lowobservable/channel/README.md

# channel

IBM parallel channel adapter.

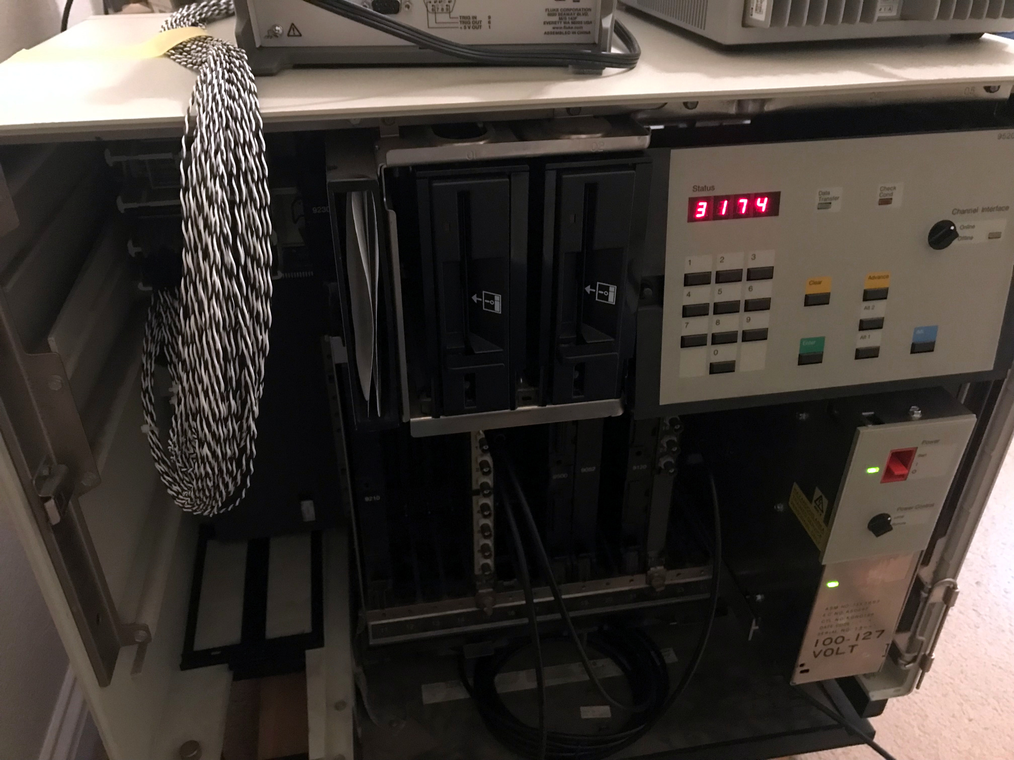
[picture p1: .images/photo1.jpg]
IBM 3174-1L


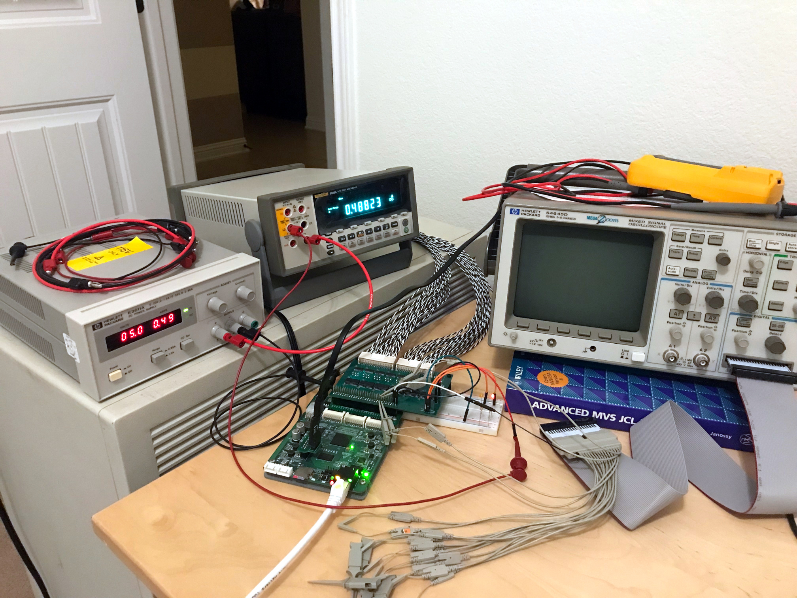
[picture p2: .images/photo2.jpg]
Adapter


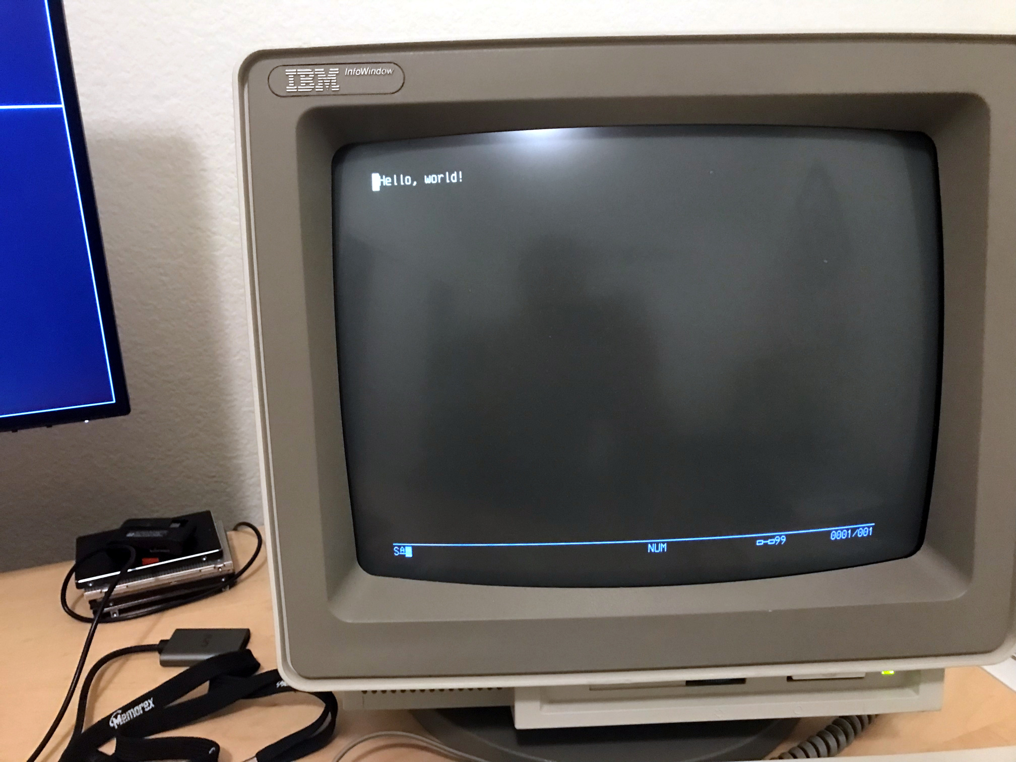
[picture p3: .images/photo3.jpg]
Hello World
