lowobservable/channel/adapter1/pcb/pinout.ods

Sheet: Pins
 | Signal | Zynq | J3 | J1 / J2 | Channel
Bus | Mark 0 In | H20 | 23 | J1 – 1 | Bus Out - J13
 | Mark 0 Out | M18 | 32 | J1 – 3 | Bus Out - D13
 | Bus In 7 | G19 | 24 | J1 – 5 | Bus Out - G12
 | Bus Out 7 | L19 | 29 | J1 – 7 | Bus Out - B12
 | Bus In 6 | D18 | 9 | J1 – 9 | Bus Out - J11
 | Bus Out 6 | J18 | 21 | J1 – 11 | Bus Out - D11
 | Bus In 5 | D20 | 10 | J1 – 13 | Bus Out - G10
 | Bus Out 5 | G20 | 22 | J1 – 15 | Bus Out - B10
 | Bus In 4 | C20 | 7 | J1 – 17 | Bus Out - J9
 | Bus Out 4 | K17 | 15 | J1 – 19 | Bus Out - D9
 | Bus In 3 | H17 | 8 | J1 – 21 | Bus Out - G8
 | Bus Out 3 | F19 | 16 | J1 – 23 | Bus Out - B8
 | Bus In 2 | B20 | 5 | J1 – 25 | Bus Out - J6
 | Bus Out 2 | E19 | 13 | J1 – 27 | Bus Out - D6
 | Bus In 1 | B19 | 6 | J1 – 29 | Bus Out - G5
 | Bus Out 1 | F20 | 14 | J1 – 31 | Bus Out - B5
 | Bus In 0 | H16 | 3 | J1 – 33 | Bus Out - J4
 | Bus Out 0 | D19 | 11 | J1 – 35 | Bus Out - D4
 | Bus In P | A20 | 4 | J1 – 37 | Bus Out - G3
 | Bus Out P | H18 | 12 | J1 – 39 | Bus Out - B3
Tag | Operational Out | T19 | 49 | J2 – 1 | Tag Out - J13
 | Service Out | U20 | 50 | J2 – 3 | Tag Out - D13
 | Hold Out | V20 | 52 | J2 – 5 | Tag Out - G12
 | Suppress Out | T20 | 47 | J2 – 7 | Tag Out - B12
 | Disconnect In | N17 | 43 | J2 – 9 | Tag Out - J11
 | Command Out | P19 | 48 | J2 – 11 | Tag Out - D11
 | Data Out | R19 | 45 | J2 – 13 | Tag Out - G10
 | Address Out | N20 | 39 | J2 – 15 | Tag Out - B10
 | Select Out | P18 | 42 | J2 – 19 | Tag Out - D9
 | Data In | R18 | 46 | J2 – 21 | Tag Out - G8
 | Select In | P20 | 44 | J2 – 23 | Tag Out - B8
 | Request In | M17 | 41 | J2 – 25 | Tag Out - J6
 | Service In | L16 | 30 | J2 – 27 | Tag Out - D6
 | Metering In | J20 | 27 | J2 – 29 | Tag Out - G5
 | Address In | K19 | 28 | J2 – 31 | Tag Out - B5
 | Metering Out | M19 | 40 | J2 – 33 | Tag Out - J4
 | Status In | J19 | 25 | J2 – 35 | Tag Out - D4
 | Clock Out | L20 | 31 | J2 – 37 | Tag Out - G3
 | Operational In | K18 | 26 | J2 – 39 | Tag Out - B3
Other | Driver Enable | U19 | 51
 | GPIO 0 | L17 | 33
 | GPIO 1 | M20 | 34

Sheet: Cable
JST | “A” | JST | “A”
1 | J13 | 2 | J12
3 | D13 | 4 | D12
5 | G12 | 6 | G13
7 | B12 | 8 | B13
9 | J11 | 10 | J10
11 | D11 | 12 | D10
13 | G10 | 14 | G9
15 | B10 | 16 | B9
17 | J9 | 18 | J8
19 | D9 | 20 | D8
21 | G8 | 22 | G7
23 | B8 | 24 | B7
25 | J6 | 26 | J7
27 | D6 | 28 | D7
29 | G5 | 30 | G4
31 | B5 | 32 | B4
33 | J4 | 34 | J5
35 | D4 | 36 | D5
37 | G3 | 38 | G2
39 | B3 | 40 | B2

Sheet: EBAZ4205 Breakout
 | GND | GND
Bus In 0 | H16 | A20 | Bus In P
Bus In 2 | B20 | B19 | Bus In 1
Bus In 4 | C20 | H17 | Bus In 3
Bus In 6 | D18 | D20 | Bus In 5
Bus Out 0 | D19 | H18 | Bus Out P
Bus Out 2 | E19 | F20 | Bus Out 1
Bus Out 4 | K17 | F19 | Bus Out 3
 | GND | GND
 | 3V3 | 3V3
Bus Out 6 | J18 | G20 | Bus Out 5
Mark 0 In | H20 | G19 | Bus In 7
Status In | J19 | K18 | Operational In
Metering In | J20 | K19 | Address In
Bus Out 7 | L19 | L16 | Service In
Clock Out | L20 | M18 | Mark 0 Out
GPIO 0 | L17 | M20 | GPIO 1
 | GND | GND
 | 3V3 | 3V3
Address Out | N20 | M19 | Metering Out
Request In | M17 | P18 | Select Out
Disconnect In | N17 | P20 | Select In
Data Out | R19 | R18 | Data In
Suppress Out | T20 | P19 | Command Out
Operational Out | T19 | U20 | Service Out
Driver Enable | U19 | V20 | Hold Out
 | GND | GND
 | 3V3 | 3V3

Sheet: XDC
Signal | Zynq | Port | XDC
Mark 0 In | H20 | A_MARK_0_IN_N | set_property -dict { PACKAGE_PIN H20 IOSTANDARD LVCMOS33 } [get_ports { A_MARK_0_IN_N }]; # Mark 0 In
Mark 0 Out | M18 | A_MARK_0_OUT | set_property -dict { PACKAGE_PIN M18 IOSTANDARD LVCMOS33 } [get_ports { A_MARK_0_OUT }]; # Mark 0 Out
Bus In 7 | G19 | A_BUS_IN_N[0] | set_property -dict { PACKAGE_PIN G19 IOSTANDARD LVCMOS33 } [get_ports { A_BUS_IN_N[0] }]; # Bus In 7
Bus Out 7 | L19 | A_BUS_OUT[0] | set_property -dict { PACKAGE_PIN L19 IOSTANDARD LVCMOS33 } [get_ports { A_BUS_OUT[0] }]; # Bus Out 7
Bus In 6 | D18 | A_BUS_IN_N[1] | set_property -dict { PACKAGE_PIN D18 IOSTANDARD LVCMOS33 } [get_ports { A_BUS_IN_N[1] }]; # Bus In 6
Bus Out 6 | J18 | A_BUS_OUT[1] | set_property -dict { PACKAGE_PIN J18 IOSTANDARD LVCMOS33 } [get_ports { A_BUS_OUT[1] }]; # Bus Out 6
Bus In 5 | D20 | A_BUS_IN_N[2] | set_property -dict { PACKAGE_PIN D20 IOSTANDARD LVCMOS33 } [get_ports { A_BUS_IN_N[2] }]; # Bus In 5
Bus Out 5 | G20 | A_BUS_OUT[2] | set_property -dict { PACKAGE_PIN G20 IOSTANDARD LVCMOS33 } [get_ports { A_BUS_OUT[2] }]; # Bus Out 5
Bus In 4 | C20 | A_BUS_IN_N[3] | set_property -dict { PACKAGE_PIN C20 IOSTANDARD LVCMOS33 } [get_ports { A_BUS_IN_N[3] }]; # Bus In 4
Bus Out 4 | K17 | A_BUS_OUT[3] | set_property -dict { PACKAGE_PIN K17 IOSTANDARD LVCMOS33 } [get_ports { A_BUS_OUT[3] }]; # Bus Out 4
Bus In 3 | H17 | A_BUS_IN_N[4] | set_property -dict { PACKAGE_PIN H17 IOSTANDARD LVCMOS33 } [get_ports { A_BUS_IN_N[4] }]; # Bus In 3
Bus Out 3 | F19 | A_BUS_OUT[4] | set_property -dict { PACKAGE_PIN F19 IOSTANDARD LVCMOS33 } [get_ports { A_BUS_OUT[4] }]; # Bus Out 3
Bus In 2 | B20 | A_BUS_IN_N[5] | set_property -dict { PACKAGE_PIN B20 IOSTANDARD LVCMOS33 } [get_ports { A_BUS_IN_N[5] }]; # Bus In 2
Bus Out 2 | E19 | A_BUS_OUT[5] | set_property -dict { PACKAGE_PIN E19 IOSTANDARD LVCMOS33 } [get_ports { A_BUS_OUT[5] }]; # Bus Out 2
Bus In 1 | B19 | A_BUS_IN_N[6] | set_property -dict { PACKAGE_PIN B19 IOSTANDARD LVCMOS33 } [get_ports { A_BUS_IN_N[6] }]; # Bus In 1
Bus Out 1 | F20 | A_BUS_OUT[6] | set_property -dict { PACKAGE_PIN F20 IOSTANDARD LVCMOS33 } [get_ports { A_BUS_OUT[6] }]; # Bus Out 1
Bus In 0 | H16 | A_BUS_IN_N[7] | set_property -dict { PACKAGE_PIN H16 IOSTANDARD LVCMOS33 } [get_ports { A_BUS_IN_N[7] }]; # Bus In 0
Bus Out 0 | D19 | A_BUS_OUT[7] | set_property -dict { PACKAGE_PIN D19 IOSTANDARD LVCMOS33 } [get_ports { A_BUS_OUT[7] }]; # Bus Out 0
Bus In P | A20 | A_BUS_IN_PARITY_N | set_property -dict { PACKAGE_PIN A20 IOSTANDARD LVCMOS33 } [get_ports { A_BUS_IN_PARITY_N }]; # Bus In P
Bus Out P | H18 | A_BUS_OUT_PARITY | set_property -dict { PACKAGE_PIN H18 IOSTANDARD LVCMOS33 } [get_ports { A_BUS_OUT_PARITY }]; # Bus Out P
Operational Out | T19 | A_OPERATIONAL_OUT | set_property -dict { PACKAGE_PIN T19 IOSTANDARD LVCMOS33 } [get_ports { A_OPERATIONAL_OUT }]; # Operational Out
Service Out | U20 | A_SERVICE_OUT | set_property -dict { PACKAGE_PIN U20 IOSTANDARD LVCMOS33 } [get_ports { A_SERVICE_OUT }]; # Service Out
Hold Out | V20 | A_HOLD_OUT | set_property -dict { PACKAGE_PIN V20 IOSTANDARD LVCMOS33 } [get_ports { A_HOLD_OUT }]; # Hold Out
Suppress Out | T20 | A_SUPPRESS_OUT | set_property -dict { PACKAGE_PIN T20 IOSTANDARD LVCMOS33 } [get_ports { A_SUPPRESS_OUT }]; # Suppress Out
Disconnect In | N17 | A_DISCONNECT_IN_N | set_property -dict { PACKAGE_PIN N17 IOSTANDARD LVCMOS33 } [get_ports { A_DISCONNECT_IN_N }]; # Disconnect In
Command Out | P19 | A_COMMAND_OUT | set_property -dict { PACKAGE_PIN P19 IOSTANDARD LVCMOS33 } [get_ports { A_COMMAND_OUT }]; # Command Out
Data Out | R19 | A_DATA_OUT | set_property -dict { PACKAGE_PIN R19 IOSTANDARD LVCMOS33 } [get_ports { A_DATA_OUT }]; # Data Out
Address Out | N20 | A_ADDRESS_OUT | set_property -dict { PACKAGE_PIN N20 IOSTANDARD LVCMOS33 } [get_ports { A_ADDRESS_OUT }]; # Address Out
Select Out | P18 | A_SELECT_OUT | set_property -dict { PACKAGE_PIN P18 IOSTANDARD LVCMOS33 } [get_ports { A_SELECT_OUT }]; # Select Out
Data In | R18 | A_DATA_IN_N | set_property -dict { PACKAGE_PIN R18 IOSTANDARD LVCMOS33 } [get_ports { A_DATA_IN_N }]; # Data In
Select In | P20 | A_SELECT_IN_N | set_property -dict { PACKAGE_PIN P20 IOSTANDARD LVCMOS33 } [get_ports { A_SELECT_IN_N }]; # Select In
Request In | M17 | A_REQUEST_IN_N | set_property -dict { PACKAGE_PIN M17 IOSTANDARD LVCMOS33 } [get_ports { A_REQUEST_IN_N }]; # Request In
Service In | L16 | A_SERVICE_IN_N | set_property -dict { PACKAGE_PIN L16 IOSTANDARD LVCMOS33 } [get_ports { A_SERVICE_IN_N }]; # Service In
Metering In | J20 | A_METERING_IN_N | set_property -dict { PACKAGE_PIN J20 IOSTANDARD LVCMOS33 } [get_ports { A_METERING_IN_N }]; # Metering In
Address In | K19 | A_ADDRESS_IN_N | set_property -dict { PACKAGE_PIN K19 IOSTANDARD LVCMOS33 } [get_ports { A_ADDRESS_IN_N }]; # Address In
Metering Out | M19 | A_METERING_OUT | set_property -dict { PACKAGE_PIN M19 IOSTANDARD LVCMOS33 } [get_ports { A_METERING_OUT }]; # Metering Out
Status In | J19 | A_STATUS_IN_N | set_property -dict { PACKAGE_PIN J19 IOSTANDARD LVCMOS33 } [get_ports { A_STATUS_IN_N }]; # Status In
Clock Out | L20 | A_CLOCK_OUT | set_property -dict { PACKAGE_PIN L20 IOSTANDARD LVCMOS33 } [get_ports { A_CLOCK_OUT }]; # Clock Out
Operational In | K18 | A_OPERATIONAL_IN_N | set_property -dict { PACKAGE_PIN K18 IOSTANDARD LVCMOS33 } [get_ports { A_OPERATIONAL_IN_N }]; # Operational In
Driver Enable | U19 | DRIVER_ENABLE | set_property -dict { PACKAGE_PIN U19 IOSTANDARD LVCMOS33 } [get_ports { DRIVER_ENABLE }]; # Driver Enable
GPIO 0 | L17 | GPIO[0] | set_property -dict { PACKAGE_PIN L17 IOSTANDARD LVCMOS33 } [get_ports { GPIO[0] }]; # GPIO 0
GPIO 1 | M20 | GPIO[1] | set_property -dict { PACKAGE_PIN M20 IOSTANDARD LVCMOS33 } [get_ports { GPIO[1] }]; # GPIO 1
