lowobservable/channel/pinout.ods

Sheet: Sheet1
Out (“A”-Style / Light) |  |  |  |  |  |  |  |  |  |  |  |  |  |  |  |  |  |  |  |  |  |  |  | In (“B”-Style / Dark)
B2 | B3 | B4 | B5 | B6 | B7 | B8 | B9 | B10 | B11 | B12 | B13 | G2 | G3 | G4 | G5 | G6 | G7 | G8 | G9 | G10 | G11 | G12 | G13 | D2 | D3 | D4 | D5 | D6 | D7 | D8 | D9 | D10 | D11 | D12 | D13 | J2 | J3 | J4 | J5 | J6 | J7 | J8 | J9 | J10 | J11 | J12 | J13
D2 | D3 | D4 | D5 | D6 | D7 | D8 | D9 | D10 | D11 | D12 | D13 | J2 | J3 | J4 | J5 | J6 | J7 | J8 | J9 | J10 | J11 | J12 | J13 | B2 | B3 | B4 | B5 | B6 | B7 | B8 | B9 | B10 | B11 | B12 | B13 | G2 | G3 | G4 | G5 | G6 | G7 | G8 | G9 | G10 | G11 | G12 | G13
Channel / Control Unit Bus Out (“A”-Style / Light) |  |  |  |  |  |  |  |  |  |  |  |  |  |  |  |  |  |  |  |  |  |  |  | Control Unit Bus In (“B”-Style / Dark)
Shield | Bus 0 Out P | Shield | Bus 0 Out 1 | X | Shield | Bus 0 Out 3 | Shield | Bus 0 Out 5 | X | Bus 0 Out 7 | Shield | Shield | Bus 0 In P | Shield | Bus 0 In 1 | X | Shield | Bus 0 In 3 | Shield | Bus 0 In 5 | X | Bus 0 In 7 | Shield | X | X | Bus 0 Out 0 | Shield | Bus 0 Out 2 | Shield | Shield | Bus 0 Out 4 | Shield | Bus 0 Out 6 | Shield | Mark 0 Out | X | X | Bus 0 In 0 | Shield | Bus 0 In 2 | Shield | Shield | Bus 0 In 4 | Shield | Bus 0 In 6 | Shield | Mark 0 In
B2 | B3 | B4 | B5 | B6 | B7 | B8 | B9 | B10 | B11 | B12 | B13 | G2 | G3 | G4 | G5 | G6 | G7 | G8 | G9 | G10 | G11 | G12 | G13 | D2 | D3 | D4 | D5 | D6 | D7 | D8 | D9 | D10 | D11 | D12 | D13 | J2 | J3 | J4 | J5 | J6 | J7 | J8 | J9 | J10 | J11 | J12 | J13
D2 | D3 | D4 | D5 | D6 | D7 | D8 | D9 | D10 | D11 | D12 | D13 | J2 | J3 | J4 | J5 | J6 | J7 | J8 | J9 | J10 | J11 | J12 | J13 | B2 | B3 | B4 | B5 | B6 | B7 | B8 | B9 | B10 | B11 | B12 | B13 | G2 | G3 | G4 | G5 | G6 | G7 | G8 | G9 | G10 | G11 | G12 | G13
X | X | Bus 0 Out 0 | Shield | Bus 0 Out 2 | Shield | Shield | Bus 0 Out 4 | Shield | Bus 0 Out 6 | Shield | Mark 0 Out | X | X | Bus 0 In 0 | Shield | Bus 0 In 2 | Shield | Shield | Bus 0 In 4 | Shield | Bus 0 In 6 | Shield | Mark 0 In | Shield | Bus 0 Out P | Shield | Bus 0 Out 1 | X | Shield | Bus 0 Out 3 | Shield | Bus 0 Out 5 | X | Bus 0 Out 7 | Shield | Shield | Bus 0 In P | Shield | Bus 0 In 1 | X | Shield | Bus 0 In 3 | Shield | Bus 0 In 5 | X | Bus 0 In 7 | Shield
Channel / Control Unit Tag Out (“A”-Style / Light) |  |  |  |  |  |  |  |  |  |  |  |  |  |  |  |  |  |  |  |  |  |  |  | Control Unit Tag In (“B”-Style / Dark)
Shield | Operational In | Shield | Address In | X | Shield | Select In | Shield | Address Out | X | Suppress Out | Shield | Shield | Clock Out | Shield | Metering In | X | Shield | Data In | Shield | Data Out | X | Hold Out | Shield | X | X | Status In | Shield | Service In | Shield | Shield | Select Out | Shield | Command Out | Shield | Service Out | X | X | Metering Out | Shield | Request In | Shield | Shield | Special Use | Shield | Disconnect In | Shield | Operational Out
B2 | B3 | B4 | B5 | B6 | B7 | B8 | B9 | B10 | B11 | B12 | B13 | G2 | G3 | G4 | G5 | G6 | G7 | G8 | G9 | G10 | G11 | G12 | G13 | D2 | D3 | D4 | D5 | D6 | D7 | D8 | D9 | D10 | D11 | D12 | D13 | J2 | J3 | J4 | J5 | J6 | J7 | J8 | J9 | J10 | J11 | J12 | J13
D2 | D3 | D4 | D5 | D6 | D7 | D8 | D9 | D10 | D11 | D12 | D13 | J2 | J3 | J4 | J5 | J6 | J7 | J8 | J9 | J10 | J11 | J12 | J13 | B2 | B3 | B4 | B5 | B6 | B7 | B8 | B9 | B10 | B11 | B12 | B13 | G2 | G3 | G4 | G5 | G6 | G7 | G8 | G9 | G10 | G11 | G12 | G13
X | X | Status In | Shield | Service In | Shield | Shield | Select Out | Shield | Command Out | Shield | Service Out | X | X | Metering Out | Shield | Request In | Shield | Shield | Special Use | Shield | Disconnect In | Shield | Operational Out | Shield | Operational In | Shield | Address In | X | Shield | Select In | Shield | Address Out | X | Suppress Out | Shield | Shield | Clock Out | Shield | Metering In | X | Shield | Data In | Shield | Data Out | X | Hold Out | Shield

Sheet: Sheet2
Pin | Signal
 | Bus | Tag
B2 | Shield | Shield
B3 | Bus 0 Out P | Operational In
B4 | Shield | Shield
B5 | Bus 0 Out 1 | Address In
B6 | X | X
B7 | Shield | Shield
B8 | Bus 0 Out 3 | Select In
B9 | Shield | Shield
B10 | Bus 0 Out 5 | Address Out
B11 | X | X
B12 | Bus 0 Out 7 | Suppress Out
B13 | Shield | Shield
D2 | X | X
D3 | X | X
D4 | Bus 0 Out 0 | Status In
D5 | Shield | Shield
D6 | Bus 0 Out 2 | Service In
D7 | Shield | Shield
D8 | Shield | Shield
D9 | Bus 0 Out 4 | Select Out
D10 | Shield | Shield
D11 | Bus 0 Out 6 | Command Out
D12 | Shield | Shield
D13 | Mark 0 Out | Service Out
G2 | Shield | Shield
G3 | Bus 0 In P | Clock Out
G4 | Shield | Shield
G5 | Bus 0 In 1 | Metering In
G6 | X | X
G7 | Shield | Shield
G8 | Bus 0 In 3 | Data In
G9 | Shield | Shield
G10 | Bus 0 In 5 | Data Out
G11 | X | X
G12 | Bus 0 In 7 | Hold Out
G13 | Shield | Shield
J2 | X | X
J3 | X | X
J4 | Bus 0 In 0 | Metering Out
J5 | Shield | Shield
J6 | Bus 0 In 2 | Request In
J7 | Shield | Shield
J8 | Shield | Shield
J9 | Bus 0 In 4 | Special Use
J10 | Shield | Shield
J11 | Bus 0 In 6 | Disconnect In
J12 | Shield | Shield
J13 | Mark 0 In | Operational Out
