lowobservable/channel/adapter1/pcb/breakout1.kicad_pcb

## KiCad design adapter1/pcb/breakout1.kicad_pcb (2024-07-01)

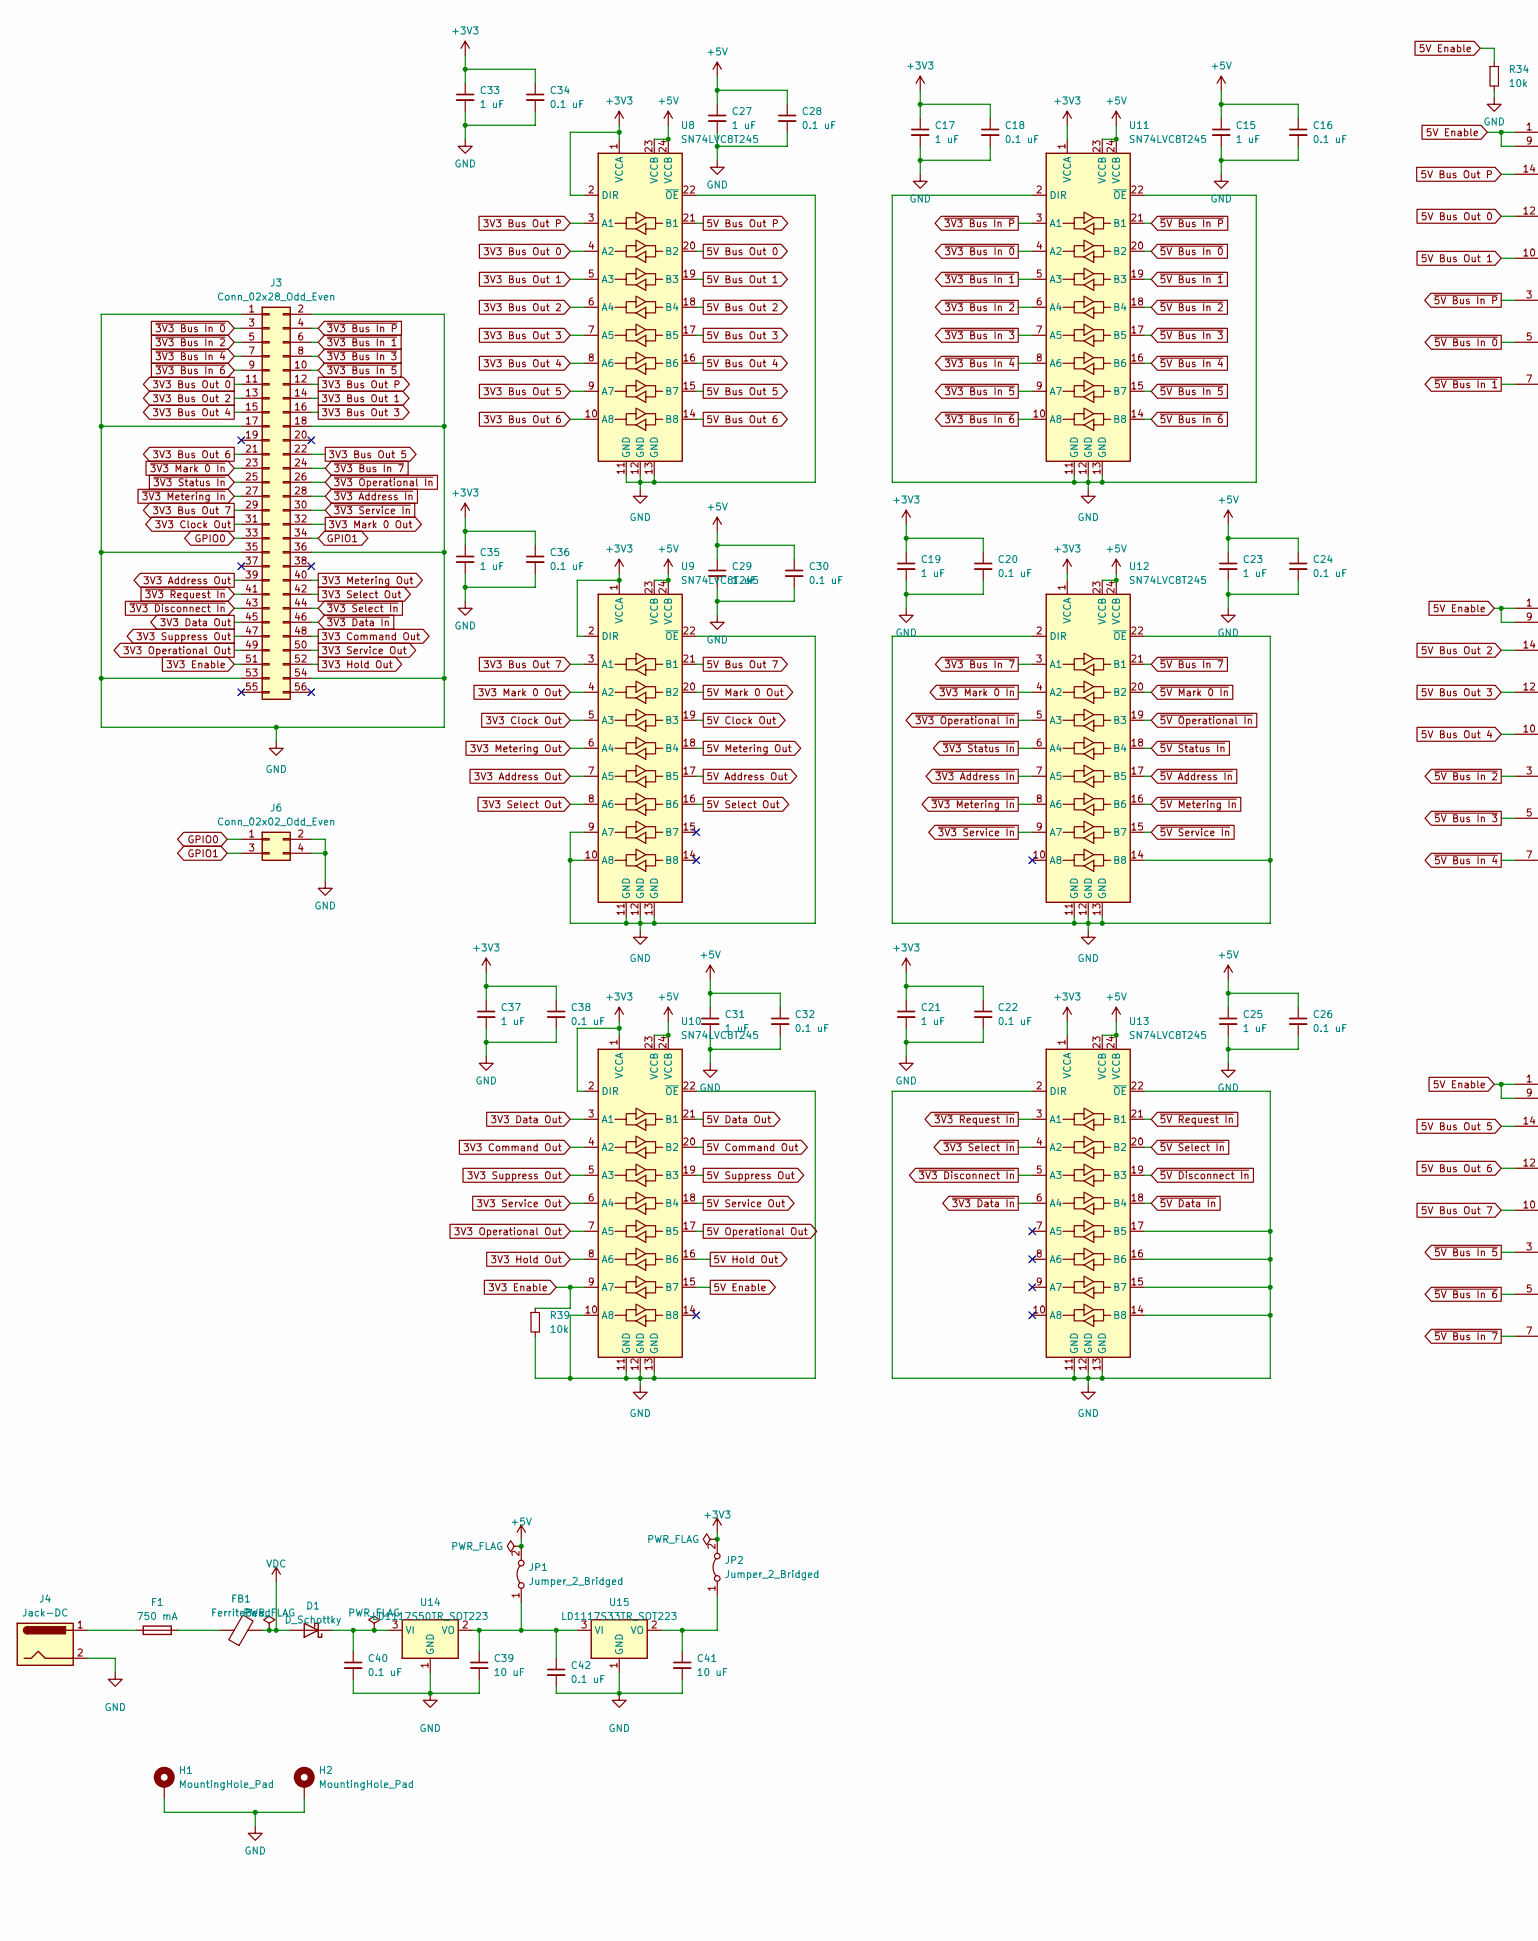
[picture p4: schematic breakout1.kicad_sch, IBM Channel Breakout Board, part in row 1, column 1]

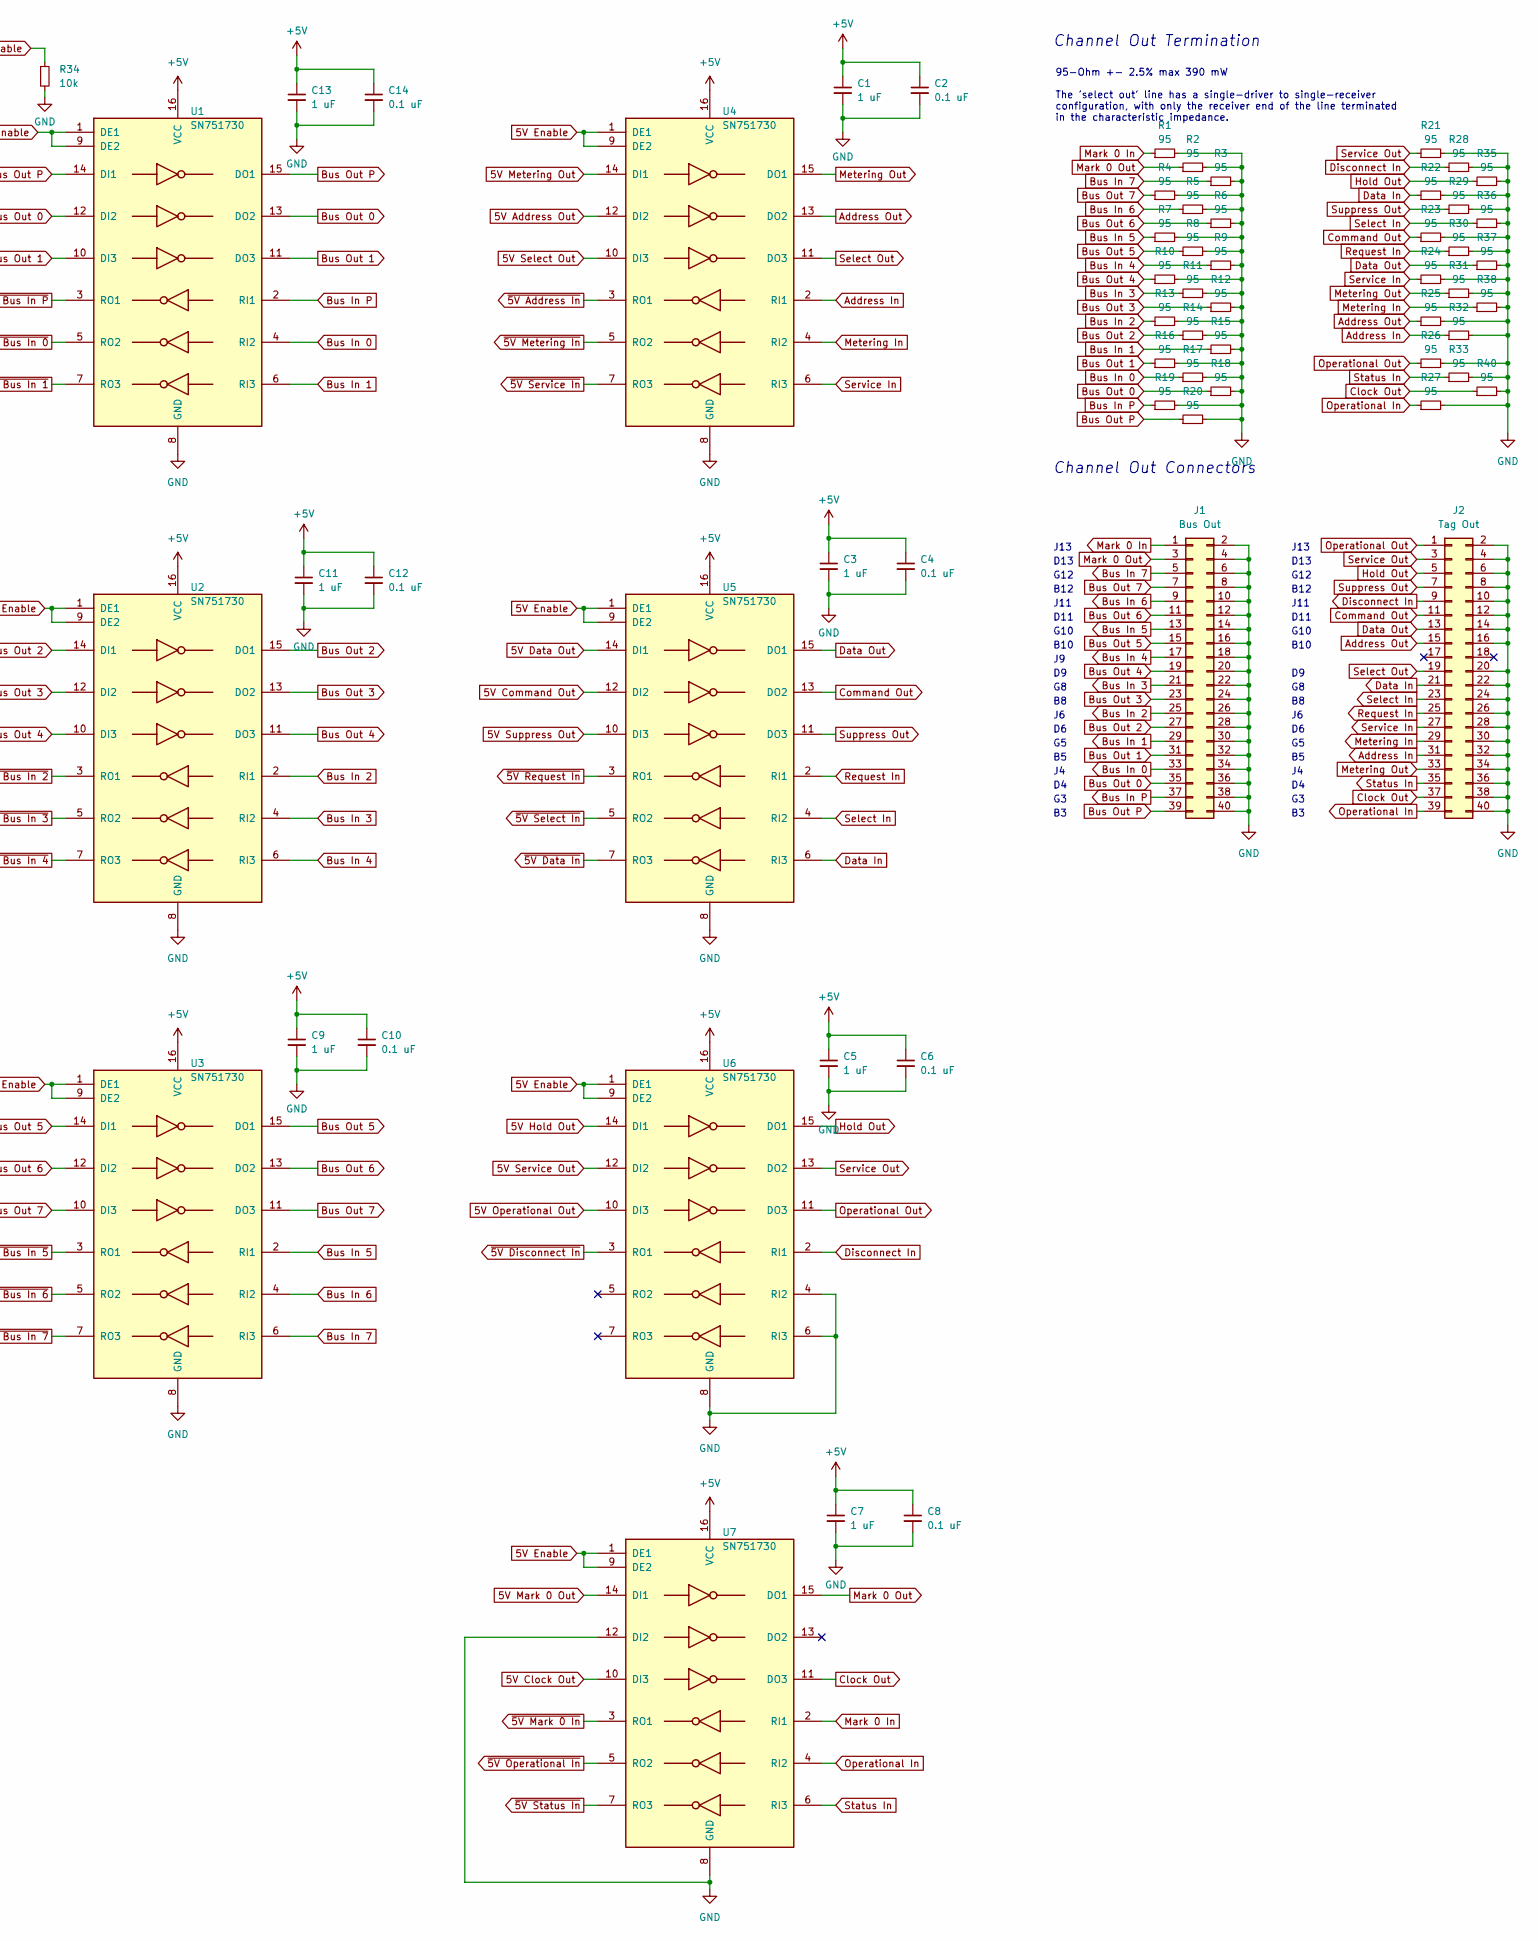
[picture p5: schematic breakout1.kicad_sch, IBM Channel Breakout Board, part in row 1, column 2]

Parts:
C1, C3, C5, C7, C9, C11, C13, C15, C17, C19, C21, C23, C25, C27, C29, C31, C33, C35, C37: 1 uF; C_0603_1608Metric; Part CL10A105KP8NNNC
C2, C4, C6, C8, C10, C12, C14, C16, C18, C20, C22, C24, C26, C28, C30, C32, C34, C36, C38, C40, C42: 0.1 uF; C_0603_1608Metric; Part CL10B104KB8NNNC
C39, C41: 10 uF; C_0603_1608Metric; Part CL10A106KP8NNNC
D1: D_Schottky; D_1206_3216Metric; Part SD1206T020S1R0
F1: 750 mA; Fuse_1206_3216Metric; Part ERB-RG0R75V
FB1: FerriteBead; Fuse_1206_3216Metric; Part CZP2BPTTE101P
H1, H2: MountingHole_Pad; MountingHole_2.7mm_M2.5_ISO7380_Pad
J1: Bus Out; JST_PUD_S40B-PUDSS-1_2x20_P2.00mm_Horizontal; Part S40B-PUDSS-1
J2: Tag Out; JST_PUD_S40B-PUDSS-1_2x20_P2.00mm_Horizontal; Part S40B-PUDSS-1
J3: Conn_02x28_Odd_Even; PinSocket_2x28_P2.54mm_Vertical
J4: Jack-DC; BarrelJack_Horizontal; Part KLDX-0202-A
J6: Conn_02x02_Odd_Even; PinHeader_2x02_P2.54mm_Vertical
JP1, JP2: Jumper_2_Bridged; PinHeader_1x02_P2.54mm_Vertical
R1, R2, R3, R4, R5, R6, R7, R8, R9, R10, R11, R12, R13, R14, R15, R16, R17, R18, R19, R20, R21, R22, R23, R24, R25, R26, R27, R28, R29, R30, R31, R32, R33, R35, R36, R37, R38, R40: 95; R_0805_2012Metric; Part ERJ-P06F95R3V
R34, R39: 10k; R_0603_1608Metric; Part RC0603FR-0710KP
U1, U2, U3, U4, U5, U6, U7: SN751730; SOIC-16_3.9x9.9mm_P1.27mm; Part SN751730D
U8, U9, U10, U11, U12, U13: SN74LVC8T245; SOIC-24W_7.5x15.4mm_P1.27mm; Part SN74LVC8T245DWRG4
U14: LD1117S50TR_SOT223; SOT-223-3_TabPin2; Part LD1117S50TR
U15: LD1117S33TR_SOT223; SOT-223-3_TabPin2; Part LD1117S33TR

Connections:
3V3 Address Out: J3.39, U9.7 (A5)
3V3 Bus Out 0: J3.11, U8.4 (A2)
3V3 Bus Out 1: J3.14, U8.5 (A3)
3V3 Bus Out 2: J3.13, U8.6 (A4)
3V3 Bus Out 3: J3.16, U8.7 (A5)
3V3 Bus Out 4: J3.15, U8.8 (A6)
3V3 Bus Out 5: J3.22, U8.9 (A7)
3V3 Bus Out 6: J3.21, U8.10 (A8)
3V3 Bus Out 7: J3.29, U9.3 (A1)
3V3 Bus Out P: J3.12, U8.3 (A1)
3V3 Clock Out: J3.31, U9.5 (A3)
3V3 Command Out: J3.48, U10.4 (A2)
3V3 Data Out: J3.45, U10.3 (A1)
3V3 Enable: J3.51, R39.1, U10.9 (A7)
3V3 Hold Out: J3.52, U10.8 (A6)
3V3 Mark 0 Out: J3.32, U9.4 (A2)
3V3 Metering Out: J3.40, U9.6 (A4)
3V3 Operational Out: J3.49, U10.7 (A5)
3V3 Select Out: J3.42, U9.8 (A6)
3V3 Service Out: J3.50, U10.6 (A4)
3V3 Suppress Out: J3.47, U10.5 (A3)
5V Address Out: U4.12 (DI2), U9.17 (B5)
5V Bus Out 0: U1.12 (DI2), U8.20 (B2)
5V Bus Out 1: U1.10 (DI3), U8.19 (B3)
5V Bus Out 2: U2.14 (DI1), U8.18 (B4)
5V Bus Out 3: U2.12 (DI2), U8.17 (B5)
5V Bus Out 4: U2.10 (DI3), U8.16 (B6)
5V Bus Out 5: U3.14 (DI1), U8.15 (B7)
5V Bus Out 6: U3.12 (DI2), U8.14 (B8)
5V Bus Out 7: U3.10 (DI3), U9.21 (B1)
5V Bus Out P: U1.14 (DI1), U8.21 (B1)
5V Clock Out: U7.10 (DI3), U9.19 (B3)
5V Command Out: U5.12 (DI2), U10.20 (B2)
5V Data Out: U5.14 (DI1), U10.21 (B1)
5V Enable: R34.1, U1.1 (DE1), U1.9 (DE2), U2.1 (DE1), U2.9 (DE2), U3.1 (DE1), U3.9 (DE2), U4.1 (DE1), U4.9 (DE2), U5.1 (DE1), U5.9 (DE2), U6.1 (DE1), U6.9 (DE2), U7.1 (DE1), U7.9 (DE2), U10.15 (B7)
5V Hold Out: U6.14 (DI1), U10.16 (B6)
5V Mark 0 Out: U7.14 (DI1), U9.20 (B2)
5V Metering Out: U4.14 (DI1), U9.18 (B4)
5V Operational Out: U6.10 (DI3), U10.17 (B5)
5V Select Out: U4.10 (DI3), U9.16 (B6)
5V Service Out: U6.12 (DI2), U10.18 (B4)
5V Suppress Out: U5.10 (DI3), U10.19 (B3)
+3V3: C17.1, C18.1, C19.1, C20.1, C21.1, C22.1, C33.1, C34.1, C35.1, C36.1, C37.1, C38.1, JP2.2 (B), U8.1 (VCCA), U8.2 (DIR), U9.1 (VCCA), U9.2 (DIR), U10.1 (VCCA), U10.2 (DIR), U11.1 (VCCA), U12.1 (VCCA), U13.1 (VCCA)
+5V: C1.1, C2.1, C3.1, C4.1, C5.1, C6.1, C7.1, C8.1, C9.1, C10.1, C11.1, C12.1, C13.1, C14.1, C15.1, C16.1, C23.1, C24.1, C25.1, C26.1, C27.1, C28.1, C29.1, C30.1, C31.1, C32.1, JP1.2 (B), U1.16 (VCC), U2.16 (VCC), U3.16 (VCC), U4.16 (VCC), U5.16 (VCC), U6.16 (VCC), U7.16 (VCC), U8.23 (VCCB), U8.24 (VCCB), U9.23 (VCCB), U9.24 (VCCB), U10.23 (VCCB), U10.24 (VCCB), U11.23 (VCCB), U11.24 (VCCB), U12.23 (VCCB), U12.24 (VCCB), U13.23 (VCCB), U13.24 (VCCB)
Address In: J2.31, R32.1, U4.2 (RI1)
Address Out: J2.15, R25.1, U4.13 (DO2)
Bus In 0: J1.33, R17.1, U1.4 (RI2)
Bus In 1: J1.29, R15.1, U1.6 (RI3)
Bus In 2: J1.25, R13.1, U2.2 (RI1)
Bus In 3: J1.21, R11.1, U2.4 (RI2)
Bus In 4: J1.17, R9.1, U2.6 (RI3)
Bus In 5: J1.13, R7.1, U3.2 (RI1)
Bus In 6: J1.9, R5.1, U3.4 (RI2)
Bus In 7: J1.5, R3.1, U3.6 (RI3)
Bus In P: J1.37, R19.1, U1.2 (RI1)
Bus Out 0: J1.35, R18.1, U1.13 (DO2)
Bus Out 1: J1.31, R16.1, U1.11 (DO3)
Bus Out 2: J1.27, R14.1, U2.15 (DO1)
Bus Out 3: J1.23, R12.1, U2.13 (DO2)
Bus Out 4: J1.19, R10.1, U2.11 (DO3)
Bus Out 5: J1.15, R8.1, U3.15 (DO1)
Bus Out 6: J1.11, R6.1, U3.13 (DO2)
Bus Out 7: J1.7, R4.1, U3.11 (DO3)
Bus Out P: J1.39, R20.1, U1.15 (DO1)
Clock Out: J2.37, R40.1, U7.11 (DO3)
Command Out: J2.11, R23.1, U5.13 (DO2)
Data In: J2.21, R22.1, U5.6 (RI3)
Data Out: J2.13, R37.1, U5.15 (DO1)
Disconnect In: J2.9, R28.1, U6.2 (RI1)
GND: C1.2, C2.2, C3.2, C4.2, C5.2, C6.2, C7.2, C8.2, C9.2, C10.2, C11.2, C12.2, C13.2, C14.2, C15.2, C16.2, C17.2, C18.2, C19.2, C20.2, C21.2, C22.2, C23.2, C24.2, C25.2, C26.2, C27.2, C28.2, C29.2, C30.2, C31.2, C32.2, C33.2, C34.2, C35.2, C36.2, C37.2, C38.2, C39.2, C40.2, C41.2, C42.2, H1.1, H2.1, J1.2, J1.4, J1.6, J1.8, J1.10, J1.12, J1.14, J1.16, J1.18, J1.20, J1.22, J1.24, J1.26, J1.28, J1.30, J1.32, J1.34, J1.36, J1.38, J1.40, J2.2, J2.4, J2.6, J2.8, J2.10, J2.12, J2.14, J2.16, J2.20, J2.22, J2.24, J2.26, J2.28, J2.30, J2.32, J2.34, J2.36, J2.38, J2.40, J3.1, J3.2, J3.17, J3.18, J3.35, J3.36, J3.53, J3.54, J4.2, J6.2, J6.4, R1.2, R2.2, R3.2, R4.2, R5.2, R6.2, R7.2, R8.2, R9.2, R10.2, R11.2, R12.2, R13.2, R14.2, R15.2, R16.2, R17.2, R18.2, R19.2, R20.2, R21.2, R22.2, R23.2, R24.2, R25.2, R26.2, R27.2, R28.2, R29.2, R30.2, R31.2, R32.2, R33.2, R34.2, R35.2, R36.2, R37.2, R38.2, R39.2, R40.2, U1.8 (GND), U2.8 (GND), U3.8 (GND), U4.8 (GND), U5.8 (GND), U6.4 (RI2), U6.6 (RI3), U6.8 (GND), U7.8 (GND), U7.12 (DI2), U8.11 (GND), U8.12 (GND), U8.13 (GND), U8.22 (~OE), U9.9 (A7), U9.10 (A8), U9.11 (GND), U9.12 (GND), U9.13 (GND), U9.22 (~OE), U10.10 (A8), U10.11 (GND), U10.12 (GND), U10.13 (GND), U10.22 (~OE), U11.2 (DIR), U11.11 (GND), U11.12 (GND), U11.13 (GND), U11.22 (~OE), U12.2 (DIR), U12.11 (GND), U12.12 (GND), U12.13 (GND), U12.14 (B8), U12.22 (~OE), U13.2 (DIR), U13.11 (GND), U13.12 (GND), U13.13 (GND), U13.14 (B8), U13.15 (B7), U13.16 (B6), U13.17 (B5), U13.22 (~OE), U14.1 (GND), U15.1 (GND)
GPIO0: J3.33, J6.1
GPIO1: J3.34, J6.3
Hold Out: J2.5, R35.1, U6.15 (DO1)
Mark 0 In: J1.1, R1.1, U7.2 (RI1)
Mark 0 Out: J1.3, R2.1, U7.15 (DO1)
Metering In: J2.29, R38.1, U4.4 (RI2)
Metering Out: J2.33, R31.1, U4.15 (DO1)
unnamed: C40.1, D1.1 (K), U14.3 (VI)
unnamed: F1.1, J4.1
unnamed: F1.2, FB1.1
unnamed: C39.1, C42.1, JP1.1 (A), U14.2 (VO), U15.3 (VI)
unnamed: C41.1, JP2.1 (A), U15.2 (VO)
Operational In: J2.39, R27.1, U7.4 (RI2)
Operational Out: J2.1, R26.1, U6.11 (DO3)
Request In: J2.25, R30.1, U5.2 (RI1)
Select In: J2.23, R36.1, U5.4 (RI2)
Select Out: J2.19, U4.11 (DO3)
Service In: J2.27, R24.1, U4.6 (RI3)
Service Out: J2.3, R21.1, U6.13 (DO2)
Status In: J2.35, R33.1, U7.6 (RI3)
Suppress Out: J2.7, R29.1, U5.11 (DO3)
VDC: D1.2 (A), FB1.2
~3V3 Address In: J3.28, U12.7 (A5)
~3V3 Bus In 0: J3.3, U11.4 (A2)
~3V3 Bus In 1: J3.6, U11.5 (A3)
~3V3 Bus In 2: J3.5, U11.6 (A4)
~3V3 Bus In 3: J3.8, U11.7 (A5)
~3V3 Bus In 4: J3.7, U11.8 (A6)
~3V3 Bus In 5: J3.10, U11.9 (A7)
~3V3 Bus In 6: J3.9, U11.10 (A8)
~3V3 Bus In 7: J3.24, U12.3 (A1)
~3V3 Bus In P: J3.4, U11.3 (A1)
~3V3 Data In: J3.46, U13.6 (A4)
~3V3 Disconnect In: J3.43, U13.5 (A3)
~3V3 Mark 0 In: J3.23, U12.4 (A2)
~3V3 Metering In: J3.27, U12.8 (A6)
~3V3 Operational In: J3.26, U12.5 (A3)
~3V3 Request In: J3.41, U13.3 (A1)
~3V3 Select In: J3.44, U13.4 (A2)
~3V3 Service In: J3.30, U12.9 (A7)
~3V3 Status In: J3.25, U12.6 (A4)
~5V Address In: U4.3 (RO1), U12.17 (B5)
~5V Bus In 0: U1.5 (RO2), U11.20 (B2)
~5V Bus In 1: U1.7 (RO3), U11.19 (B3)
~5V Bus In 2: U2.3 (RO1), U11.18 (B4)
~5V Bus In 3: U2.5 (RO2), U11.17 (B5)
~5V Bus In 4: U2.7 (RO3), U11.16 (B6)
~5V Bus In 5: U3.3 (RO1), U11.15 (B7)
~5V Bus In 6: U3.5 (RO2), U11.14 (B8)
~5V Bus In 7: U3.7 (RO3), U12.21 (B1)
~5V Bus In P: U1.3 (RO1), U11.21 (B1)
~5V Data In: U5.7 (RO3), U13.18 (B4)
~5V Disconnect In: U6.3 (RO1), U13.19 (B3)
~5V Mark 0 In: U7.3 (RO1), U12.20 (B2)
~5V Metering In: U4.5 (RO2), U12.16 (B6)
~5V Operational In: U7.5 (RO2), U12.19 (B3)
~5V Request In: U5.3 (RO1), U13.21 (B1)
~5V Select In: U5.5 (RO2), U13.20 (B2)
~5V Service In: U4.7 (RO3), U12.15 (B7)
~5V Status In: U7.7 (RO3), U12.18 (B4)

Notes on the sheet:
95-Ohm +- 2.5% max 390 mW The 'select out' line has a single-driver to single-receiver configuration, with only the receiver end of the line terminated in the characteristic impedance.
D13
D11
J13
G12
J11
G10
Channel Out Connectors
B12
B10
Channel Out Termination

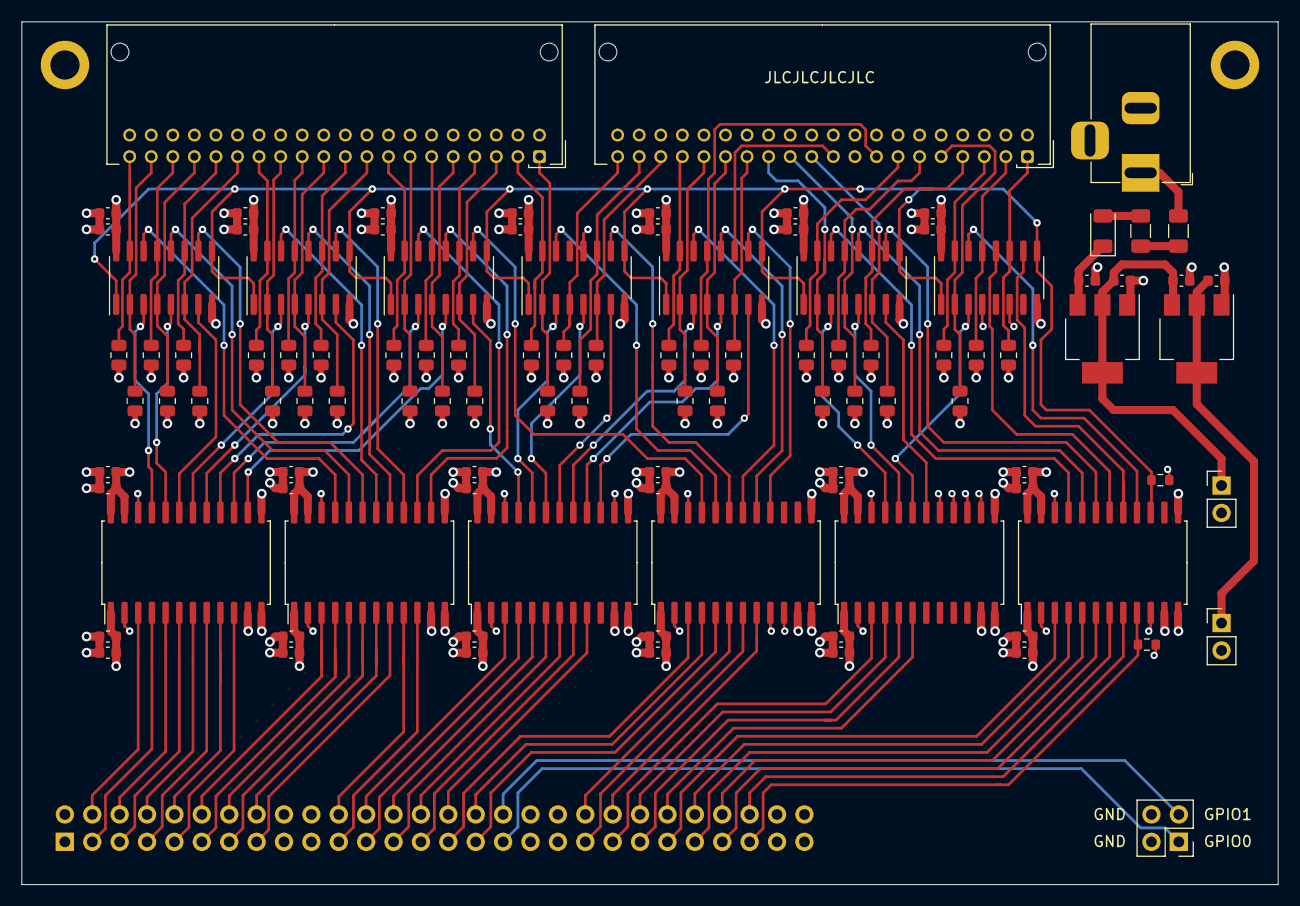
[picture p6: board breakout1.kicad_pcb from above]

Board: 4 copper layers, 116.5 x 80.0 mm, 109 parts (1 on the bottom side), 130 nets.
