lowobservable/channel/adapter1/fpga/rtl/axi_mm_channel_out.v

// Copyright (c) 2023, Andrew Kay
//
// Permission to use, copy, modify, and/or distribute this software for any
// purpose with or without fee is hereby granted, provided that the above
// copyright notice and this permission notice appear in all copies.
//
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
`default_nettype none

module axi_mm_channel_out (
    input wire aclk,
    input wire aresetn,

    // AXI4-Lite control interface...
    input wire [7:0] s_axi_araddr,
    input wire s_axi_arvalid,
    output reg s_axi_arready,

    output reg [31:0] s_axi_rdata,
    output reg [1:0] s_axi_rresp,
    output reg s_axi_rvalid,
    input wire s_axi_rready,

    input wire [7:0] s_axi_awaddr,
    input wire s_axi_awvalid,
    output reg s_axi_awready,

    input wire [31:0] s_axi_wdata,
    input wire [3:0] s_axi_wstrb,
    input wire s_axi_wvalid,
    output reg s_axi_wready,

    output reg [1:0] s_axi_bresp,
    output reg s_axi_bvalid,
    input wire s_axi_bready,

    // AXI4-Lite storage interface...
    output wire [31:0] m_axi_araddr,
    output wire m_axi_arvalid,
    input wire m_axi_arready,

    input wire [63:0] m_axi_rdata,
    input wire [1:0] m_axi_rresp,
    input wire m_axi_rvalid,
    output wire m_axi_rready,

    output wire [31:0] m_axi_awaddr,
    output wire m_axi_awvalid,
    input wire m_axi_awready,

    output wire [63:0] m_axi_wdata,
    output wire [7:0] m_axi_wstrb,
    output wire m_axi_wvalid,
    input wire m_axi_wready,

    input wire [1:0] m_axi_bresp,
    input wire m_axi_bvalid,
    output wire m_axi_bready,

    // Parallel Channel "A"...
    input wire [7:0] a_bus_in,
    input wire a_bus_in_parity,
    output wire [7:0] a_bus_out,
    output wire a_bus_out_parity,

    output wire a_operational_out,
    input wire a_request_in,
    output wire a_hold_out,
    output wire a_select_out,
    input wire a_select_in,
    output wire a_address_out,
    input wire a_operational_in,
    input wire a_address_in,
    output wire a_command_out,
    input wire a_status_in,
    input wire a_service_in,
    output wire a_service_out,
    output wire a_suppress_out,

    output reg frontend_enable,

    output reg wrap_tester_enable,
    output reg [19:0] wrap_tester_driver,
    input wire [19:0] wrap_tester_receiver,

    output wire indicator_operational,
    output wire indicator_connected,
    output wire indicator_error,

    output wire debug_0,
    output wire debug_1
);
    parameter CLOCKS_PER_100_NS = 5; // 50 MHz clock period is 20 ns

    localparam REG_CHANNEL_1 = 8'h00;
    localparam REG_CHANNEL_3 = 8'h08;
    localparam REG_CHANNEL_4 = 8'h0c;
    localparam REG_DEVICE_1 = 8'h10;
    localparam REG_DEVICE_2 = 8'h14;
    localparam REG_DEVICE_3 = 8'h18;
    localparam REG_DEVICE_4 = 8'h1c;

    reg channel_enable = 0;

    reg [7:0] device_address;
    reg device_enable;
    reg subchannel_active;
    reg device_active;
    reg [7:0] status;
    reg status_pending;
    reg clear_status_pending;
    reg status_stacked;
    reg [7:0] command;
    reg command_chained;
    reg command_chaining;
    reg [15:0] count;
    reg [31:0] storage_address;
    reg start_pending;
    reg clear_start_pending;
    reg increment = 0;
    reg [3:0] condition_code;

    // The control interface...
    //
    //     ---- ---- | ---- ---- | ---- ---- | ---- ----
    // C1:           |           |           |         E <- "Channel enable"
    //               |           |           |
    // C3: DDDD DDDD | DDDD DDDD | DDDD    W |         F <- Frontend enable
    // C4: RRRR RRRR | RRRR RRRR | RRRR    ^--------------- Wrap tester enable
    //     ---- ---- | ---- ---- | ---- ---- | ---- ----
    // D1: AAAA AAAA |           |           |         E <- "Device enable"
    // D2:           | SSSS SSSS | PS     BA | CCCC    S <- Start / Start Pending
    //                             ^^     ^^--------------- Active
    //                             ++---------------------- Pending / Stacked
    // D3: NNNN NNNN | NNNN NNNN |        DC | CCCC CCCC
    //                                    ^^--------------- Command Chained / Chaining
    // D4: AAAA AAAA | AAAA AAAA | AAAA AAAA | AAAA AAAA <- Storage address
    //
    always @(posedge aclk)
    begin
        // TODO: Without a buffer, we cannot accept a read with a response
        // pending.
        s_axi_arready <= !s_axi_rvalid;

        if (s_axi_arvalid && s_axi_arready)
        begin
            s_axi_arready <= 0;

            s_axi_rresp <= 2'b00;

            case (s_axi_araddr)
                REG_CHANNEL_1:
                begin
                    s_axi_rdata <= { 31'b0, channel_enable };
                end

                8'h04: // TODO: Temporary debug register
                begin
                    s_axi_rdata <= { channel_state, channel_error, 8'b0 };
                end

                REG_CHANNEL_3:
                begin
                    s_axi_rdata <= { wrap_tester_driver, 3'b0, wrap_tester_enable, 7'b0, frontend_enable };
                end

                REG_CHANNEL_4:
                begin
                    s_axi_rdata <= { wrap_tester_receiver, 12'b0 };
                end

                REG_DEVICE_1:
                begin
                    s_axi_rdata <= { device_address, 23'b0, device_enable };
                end

                REG_DEVICE_2:
                begin
                    s_axi_rdata <= { 8'b0, status, status_pending, status_stacked, 4'b0, subchannel_active, device_active, condition_code, 3'b0, start_pending };
                end

                REG_DEVICE_3:
                begin
                    s_axi_rdata <= { count, 6'b0, command_chained, command_chaining, command };
                end

                REG_DEVICE_4:
                begin
                    s_axi_rdata <= storage_address;
                end

                default:
                begin
                    s_axi_rresp <= 2'b10; // SLVERR
                end
            endcase

            s_axi_rvalid <= 1;
        end

        if (s_axi_rvalid && s_axi_rready)
        begin
            s_axi_rvalid <= 0;
            s_axi_arready <= 1;
        end

        if (!aresetn)
        begin
            s_axi_arready <= 0;
            s_axi_rvalid <= 0;
        end
    end

    reg [7:0] waddr;
    reg waddr_loaded;
    reg [31:0] wdata;
    // verilator lint_off UNUSEDSIGNAL
    reg [3:0] wstrb;
    // verilator lint_on UNUSEDSIGNAL
    reg wdata_loaded;

    always @(posedge aclk)
    begin
        // 1-clock pulses to communicate with channel state machine...
        clear_status_pending <= 0;

        if (clear_start_pending)
        begin
            start_pending <= 0;
        end

        if (increment)
        begin
            count <= count - 1;
            storage_address <= storage_address + 1;
        end

        s_axi_awready <= !waddr_loaded && !s_axi_bvalid;

        if (s_axi_awvalid && s_axi_awready)
        begin
            s_axi_awready <= 0;

            waddr <= s_axi_awaddr;
            waddr_loaded <= 1;
        end

        s_axi_wready <= !wdata_loaded && !s_axi_bvalid;

        if (s_axi_wvalid && s_axi_wready)
        begin
            s_axi_wready <= 0;

            wdata <= s_axi_wdata;
            wstrb <= s_axi_wstrb;
            wdata_loaded <= 1;
        end

        if (waddr_loaded && wdata_loaded)
        begin
            s_axi_bresp <= 2'b00;

            case (waddr)
                REG_CHANNEL_1:
                begin
                    // TODO: wstrb
                    channel_enable <= wdata[0];
                end

                REG_CHANNEL_3:
                begin
                    // TODO: wstrb
                    frontend_enable <= wdata[0];

                    // NOTE: Enabling the wrap test while the channel is enabled
                    // is probably undesirable, but not enforced here.
                    wrap_tester_enable <= wdata[8];
                    wrap_tester_driver <= wdata[31:12];
                end

                REG_DEVICE_1:
                begin
                    // TODO: wstrb
                    device_enable <= wdata[0];
                    device_address <= wdata[31:24];
                end

                REG_DEVICE_2:
                begin
                    // TODO: wstrb
                    if (wdata[0])
                    begin
                        // TODO: Should not be allowed if start is pending.
                        start_pending <= 1;
                    end

                    if (wdata[15])
                    begin
                        clear_status_pending <= 1;
                    end
                end

                REG_DEVICE_3:
                begin
                    // TODO: wstrb
                    command <= wdata[7:0];
                    command_chaining <= wdata[8];
                    command_chained <= wdata[9];
                    count <= wdata[31:16];
                end

                REG_DEVICE_4:
                begin
                    // TODO: wstrb
                    storage_address <= wdata;
                end

                default:
                begin
                    s_axi_bresp <= 2'b10; // SLVERR
                end
            endcase

            s_axi_bvalid <= 1;

            waddr_loaded <= 0;
            wdata_loaded <= 0;
        end

        if (s_axi_bvalid && s_axi_bready)
        begin
            s_axi_bvalid <= 0;
            s_axi_awready <= 1;
            s_axi_wready <= 1;
        end

        if (!aresetn)
        begin
            s_axi_awready <= 0;
            s_axi_wready <= 0;
            s_axi_bvalid <= 0;

            waddr_loaded <= 0;
            wdata_loaded <= 0;

            channel_enable <= 0;
            device_enable <= 0;
            start_pending <= 0;

            frontend_enable <= 0;

            wrap_tester_enable <= 0;
        end
    end

    // The channel side of things...
    reg [7:0] channel_state;

    localparam CHANNEL_STATE_IDLE = 0;
    localparam CHANNEL_STATE_START_1 = 1;
    localparam CHANNEL_STATE_START_2 = 2;
    localparam CHANNEL_STATE_START_3 = 3;
    localparam CHANNEL_STATE_REQUEST_1 = 4;
    localparam CHANNEL_STATE_REQUEST_2 = 5;
    localparam CHANNEL_STATE_CONNECTED = 6;
    localparam CHANNEL_STATE_WAIT = 7;
    localparam CHANNEL_STATE_ACCEPT_STATUS_1 = 8;
    localparam CHANNEL_STATE_STACK_STATUS_1 = 9;
    localparam CHANNEL_STATE_SEND_DATA_1 = 10;
    localparam CHANNEL_STATE_SEND_DATA_2 = 11;
    localparam CHANNEL_STATE_SEND_DATA_3 = 12;
    localparam CHANNEL_STATE_RECEIVE_DATA_1 = 13;
    localparam CHANNEL_STATE_RECEIVE_DATA_2 = 14;
    localparam CHANNEL_STATE_RECEIVE_DATA_3 = 15;
    localparam CHANNEL_STATE_STOP = 16;
    localparam CHANNEL_STATE_TEST_IO_1 = 17;
    localparam CHANNEL_STATE_TEST_IO_2 = 18;
    localparam CHANNEL_STATE_TODO = 19;

    reg [23:0] channel_in_tdata;
    reg channel_in_tvalid;
    wire channel_in_tready;

    wire [23:0] channel_out_tdata;
    wire channel_out_tvalid;
    reg channel_out_tready;

    wire [1:0] channel_data_direction;
    reg channel_suppress_status = 1;
    reg channel_burst = 0;
    wire channel_connected;
    wire channel_request;
    wire [15:0] channel_error;

    assign channel_data_direction = { 1'b1, command[0] };

    channel_out_protocol #(
        .CLOCKS_PER_100_NS(CLOCKS_PER_100_NS)
    ) protocol (
        .clk(aclk),
        .reset(!channel_enable),

        .in_tdata(channel_in_tdata),
        .in_tvalid(channel_in_tvalid),
        .in_tready(channel_in_tready),

        .out_tdata(channel_out_tdata),
        .out_tvalid(channel_out_tvalid),
        .out_tready(channel_out_tready),

        .data_direction(channel_data_direction),
        .suppress_status(channel_suppress_status),
        .burst(channel_burst),
        .connected(channel_connected),
        .request(channel_request),
        .error(channel_error),

        .a_bus_in(a_bus_in),
        .a_bus_in_parity(a_bus_in_parity),
        .a_bus_out(a_bus_out),
        .a_bus_out_parity(a_bus_out_parity),
        .a_operational_out(a_operational_out),
        .a_request_in(a_request_in),
        .a_hold_out(a_hold_out),
        .a_select_out(a_select_out),
        .a_select_in(a_select_in),
        .a_address_out(a_address_out),
        .a_operational_in(a_operational_in),
        .a_address_in(a_address_in),
        .a_command_out(a_command_out),
        .a_status_in(a_status_in),
        .a_service_in(a_service_in),
        .a_service_out(a_service_out),
        .a_suppress_out(a_suppress_out)
    );

    reg storage_write;
    wire [7:0] storage_data_read;
    reg [7:0] storage_data_write;
    reg storage_start = 0;
    wire storage_done;

    always @(posedge aclk)
    begin
        // 1-clock pulses to communicate with channel state machine...
        clear_start_pending <= 0;
        increment <= 0;

        if (clear_status_pending)
        begin
            status_pending <= 0;
        end

        channel_in_tvalid <= 0;
        channel_out_tready <= 0;

        if (channel_error[0])
        begin
            // Something is going wrong...
        end
        else if (!channel_enable)
        begin
            channel_state <= CHANNEL_STATE_IDLE;

            status_pending <= 0;
            status_stacked <= 0;
        end
        else
        begin
            case (channel_state)
                CHANNEL_STATE_IDLE:
                begin
                    if (channel_request)
                    begin
                        channel_state <= CHANNEL_STATE_REQUEST_1;
                    end
                    else if (device_enable && status_stacked && !status_pending)
                    begin
                        // Unstack status with test I/O.
                        channel_state <= CHANNEL_STATE_TEST_IO_1;
                    end
                    else if (start_pending && !clear_start_pending)
                    begin
                        if (command[3:0] == 4'h0 || command[3:0] == 4'h8)
                        begin
                            // Test I/O and other reserved commands are reserved
                            // for use by the channel subsystem.
                            condition_code <= 4'h5; // XXX - Reserved Command
                            clear_start_pending <= 1;
                        end
                        else if (!device_enable)
                        begin
                            condition_code <= 4'h1; // XXX - Device Disabled
                            clear_start_pending <= 1;
                        end
                        else if (device_active)
                        begin
                            // NOTE: This is probably not necessary, the initial
                            // selection should indicate busy in these cases.
                            condition_code <= 4'h4; // XXX - Device Busy
                            clear_start_pending <= 1;
                        end
                        else if (status_pending)
                        begin
                            // Reject the takeoff.
                            condition_code <= 4'h3; // XXX - Status Pending
                            clear_start_pending <= 1;
                        end
                        else
                        begin
                            channel_state <= CHANNEL_STATE_START_1;
                        end
                    end
                end

                CHANNEL_STATE_START_1:
                begin
                    // TODO: channel_burst <= no contention, probably

                    channel_in_tdata <= { 3'b0, command_chained, 4'h2, device_address, command }; // XXX - Initial Selection
                    channel_in_tvalid <= 1;

                    if (channel_in_tready && channel_in_tvalid)
                    begin
                        channel_in_tvalid <= 0;

                        channel_state <= CHANNEL_STATE_START_2;
                    end
                end

                CHANNEL_STATE_START_2:
                begin
                    channel_out_tready <= 1;

                    if (channel_out_tready && channel_out_tvalid)
                    begin
                        channel_out_tready <= 0;

                        if (channel_out_tdata[19:16] == 4'h1) // XXX - Status
                        begin
                            if (!channel_out_tdata[20])
                            begin
                                // Invalid parity...
                                channel_state <= CHANNEL_STATE_TODO;
                            end
                            else if (channel_out_tdata[15:8] == device_address && channel_out_tdata[23])
                            begin
                                // Defer handling of initial status.
                                status <= channel_out_tdata[7:0];

                                channel_state <= CHANNEL_STATE_START_3;
                            end
                        end
                        else if (channel_out_tdata[23:16] == 8'hff) // XXX - Error
                        begin
                            if (channel_out_tdata[15:8] == 8'h02)
                            begin
                                condition_code <= 4'h2; // XXX - Device Not Operational
                                clear_start_pending <= 1;

                                channel_state <= CHANNEL_STATE_IDLE;
                            end
                            else
                            begin
                                channel_state <= CHANNEL_STATE_TODO;
                            end
                        end
                    end
                end

                CHANNEL_STATE_START_3:
                begin
                    condition_code <= 4'h0; // XXX - Started
                    clear_start_pending <= 1;

                    if (status[4]) // Busy
                    begin
                        condition_code <= 4'h4; // XXX - Device Busy

                        channel_state <= CHANNEL_STATE_IDLE;
                    end
                    else if (status == 8'h00) // Accepted
                    begin
                        subchannel_active <= 1;
                        device_active <= 1;

                        channel_state <= CHANNEL_STATE_CONNECTED;
                    end
                    else if (status == 8'h08) // Channel End
                    begin
                        // Immediate command that no longer requires the channel,
                        // but is not device end.
                        device_active <= 1;
                        status_pending <= 1;

                        channel_state <= CHANNEL_STATE_IDLE;
                    end
                    else
                    begin
                        status_pending <= 1;

                        channel_state <= CHANNEL_STATE_IDLE;
                    end
                end

                CHANNEL_STATE_REQUEST_1:
                begin
                    // TODO: channel_burst <= no contention, probably

                    channel_in_tdata <= 24'h010000; // XXX - Select Requestor
                    channel_in_tvalid <= 1;

                    if (channel_in_tready && channel_in_tvalid)
                    begin
                        channel_in_tvalid <= 0;

                        channel_state <= CHANNEL_STATE_REQUEST_2;
                    end
                end

                CHANNEL_STATE_REQUEST_2:
                begin
                    if (channel_connected)
                    begin
                        channel_state <= CHANNEL_STATE_CONNECTED;
                    end

                    // TODO: A seperate connected event may be required so we
                    // can determine if the requestor did not respond.
                    // Alternatavely we could try peeking when TVALID without
                    // asserting TREADY but that would not be correct.
                end

                CHANNEL_STATE_CONNECTED:
                begin
                    channel_out_tready <= 1;

                    // TODO: channel_burst <= no contention, probably

                    // TODO: !device_enable handling here is probably a little
                    // more complex than outlined... this works for the simple
                    // case where a device is enabled or disabled outside of
                    // a channel initiated operation.

                    if (channel_out_tready && channel_out_tvalid)
                    begin
                        channel_out_tready <= 0;

                        if (channel_out_tdata[19:16] == 4'h1) // XXX - Status
                        begin
                            if (!channel_out_tdata[20])
                            begin
                                // Invalid parity...
                                channel_state <= CHANNEL_STATE_TODO;
                            end
                            else if (channel_out_tdata[15:8] == device_address && device_enable && !status_pending)
                            begin
                                if (subchannel_active && channel_out_tdata[3]) // Channel End
                                begin
                                    subchannel_active <= 0;
                                end

                                if (device_active && channel_out_tdata[2]) // Device End
                                begin
                                    device_active <= 0;
                                end

                                status <= channel_out_tdata[7:0];
                                status_pending <= 1;
                                status_stacked <= 0;

                                channel_state <= CHANNEL_STATE_ACCEPT_STATUS_1;
                            end
                            else
                            begin
                                status_stacked <= 1;

                                channel_state <= CHANNEL_STATE_STACK_STATUS_1;
                            end
                        end
                        else if (channel_out_tdata[19:16] == 4'h2) // XXX - Service
                        begin
                            if (count == 16'b0)
                            begin
                                channel_state <= CHANNEL_STATE_STOP;
                            end
                            else if (command[0])
                            begin
                                channel_state <= CHANNEL_STATE_SEND_DATA_1;
                            end
                            else if (!channel_out_tdata[20])
                            begin
                                // Invalid parity...
                                channel_state <= CHANNEL_STATE_TODO;
                            end
                            else
                            begin
                                storage_data_write <= channel_out_tdata[7:0];

                                channel_state <= CHANNEL_STATE_RECEIVE_DATA_1;
                            end
                        end
                        else
                        begin
                            channel_state <= CHANNEL_STATE_TODO;
                        end
                    end
                    else if (!channel_connected)
                    begin
                        channel_state <= CHANNEL_STATE_IDLE;
                    end
                end

                CHANNEL_STATE_WAIT:
                begin
                    channel_out_tready <= 1;

                    if (channel_out_tready && channel_out_tvalid)
                    begin
                        channel_out_tready <= 0;

                        if (channel_connected)
                        begin
                            channel_state <= CHANNEL_STATE_CONNECTED;
                        end
                        else
                        begin
                            channel_state <= CHANNEL_STATE_IDLE;
                        end
                    end
                end

                CHANNEL_STATE_ACCEPT_STATUS_1:
                begin
                    channel_in_tdata <= { 3'b0, command_chaining, 20'h30000 }; // XXX - Accept Status
                    channel_in_tvalid <= 1;

                    if (channel_in_tready && channel_in_tvalid)
                    begin
                        channel_in_tvalid <= 0;

                        channel_state <= CHANNEL_STATE_WAIT;
                    end
                end

                CHANNEL_STATE_STACK_STATUS_1:
                begin
                    channel_in_tdata <= 24'h040000; // XXX - Stack Status
                    channel_in_tvalid <= 1;

                    if (channel_in_tready && channel_in_tvalid)
                    begin
                        channel_in_tvalid <= 0;

                        channel_state <= CHANNEL_STATE_WAIT;
                    end
                end

                CHANNEL_STATE_SEND_DATA_1:
                begin
                    storage_write <= 0;
                    storage_start <= 1;

                    channel_state <= CHANNEL_STATE_SEND_DATA_2;
                end

                CHANNEL_STATE_SEND_DATA_2:
                begin
                    storage_start <= 0;

                    if (storage_done)
                    begin
                        channel_state <= CHANNEL_STATE_SEND_DATA_3;
                    end
                end

                CHANNEL_STATE_SEND_DATA_3:
                begin
                    channel_in_tdata <= { 8'h05, storage_data_read, 8'h00 }; // XXX - Send Data
                    channel_in_tvalid <= 1;

                    if (channel_in_tready && channel_in_tvalid)
                    begin
                        channel_in_tvalid <= 0;

                        increment <= 1;

                        channel_state <= CHANNEL_STATE_WAIT;
                    end
                end

                CHANNEL_STATE_RECEIVE_DATA_1:
                begin
                    storage_write <= 1;
                    storage_start <= 1;

                    channel_state <= CHANNEL_STATE_RECEIVE_DATA_2;
                end

                CHANNEL_STATE_RECEIVE_DATA_2:
                begin
                    storage_start <= 0;

                    if (storage_done)
                    begin
                        channel_state <= CHANNEL_STATE_RECEIVE_DATA_3;
                    end
                end

                CHANNEL_STATE_RECEIVE_DATA_3:
                begin
                    channel_in_tdata <= 24'h060000; // XXX - Accept Data
                    channel_in_tvalid <= 1;

                    if (channel_in_tready && channel_in_tvalid)
                    begin
                        channel_in_tvalid <= 0;

                        increment <= 1;

                        channel_state <= CHANNEL_STATE_WAIT;
                    end
                end

                CHANNEL_STATE_STOP:
                begin
                    channel_in_tdata <= 24'h070000; // XXX - Stop
                    channel_in_tvalid <= 1;

                    if (channel_in_tready && channel_in_tvalid)
                    begin
                        channel_in_tvalid <= 0;

                        channel_state <= CHANNEL_STATE_WAIT;
                    end
                end

                CHANNEL_STATE_TEST_IO_1:
                begin
                    // NOTE: It is not clear to me if command chained should be
                    // indicated when executing test I/O, it may be moot if
                    // stacking status resets command chaining.
                    //
                    // SPEC: The command-chaining condition [...] is reset
                    // whenever the I/O device receives [...] stack status [...]
                    channel_in_tdata <= { 8'h02, device_address, 8'h00 }; // XXX - Initial Selection
                    channel_in_tvalid <= 1;

                    if (channel_in_tready && channel_in_tvalid)
                    begin
                        channel_in_tvalid <= 0;

                        channel_state <= CHANNEL_STATE_TEST_IO_2;
                    end
                end

                CHANNEL_STATE_TEST_IO_2:
                begin
                    channel_out_tready <= 1;

                    if (channel_out_tready && channel_out_tvalid)
                    begin
                        channel_out_tready <= 0;

                        if (channel_out_tdata[19:16] == 4'h1) // XXX - Status
                        begin
                            if (!channel_out_tdata[20])
                            begin
                                // Invalid parity...
                                channel_state <= CHANNEL_STATE_TODO;
                            end
                            else if (channel_out_tdata[15:8] == device_address && channel_out_tdata[23])
                            begin
                                if (subchannel_active && channel_out_tdata[3]) // Channel End
                                begin
                                    subchannel_active <= 0;
                                end

                                if (device_active && channel_out_tdata[2]) // Device End
                                begin
                                    device_active <= 0;
                                end

                                status <= channel_out_tdata[7:0];
                                status_pending <= 1;
                                status_stacked <= 0;

                                channel_state <= CHANNEL_STATE_IDLE;
                            end
                        end
                        else if (channel_out_tdata[23:16] == 8'hff) // XXX - Error
                        begin
                            if (channel_out_tdata[15:8] == 8'h02) // XXX - Device Not Operational
                            begin
                                channel_state <= CHANNEL_STATE_IDLE;
                            end
                            else
                            begin
                                channel_state <= CHANNEL_STATE_TODO;
                            end
                        end
                    end
                end

                CHANNEL_STATE_TODO:
                begin
                    $display("TODO");
                    $finish;
                end
            endcase
        end

        if (!aresetn)
        begin
            channel_state <= CHANNEL_STATE_IDLE;

            subchannel_active <= 0;
            device_active <= 0;

            status_pending <= 0;
            status_stacked <= 0;
        end
    end

    axi_byte_io storage (
        .aclk(aclk),
        .aresetn(aresetn),

        .busy(),
        .addr(storage_address),
        .write(storage_write),
        .data_read(storage_data_read),
        .data_write(storage_data_write),
        .start(storage_start),
        .done(storage_done),

        .m_axi_araddr(m_axi_araddr),
        .m_axi_arvalid(m_axi_arvalid),
        .m_axi_arready(m_axi_arready),
        .m_axi_rdata(m_axi_rdata),
        .m_axi_rresp(m_axi_rresp),
        .m_axi_rvalid(m_axi_rvalid),
        .m_axi_rready(m_axi_rready),
        .m_axi_awaddr(m_axi_awaddr),
        .m_axi_awvalid(m_axi_awvalid),
        .m_axi_awready(m_axi_awready),
        .m_axi_wdata(m_axi_wdata),
        .m_axi_wstrb(m_axi_wstrb),
        .m_axi_wvalid(m_axi_wvalid),
        .m_axi_wready(m_axi_wready),
        .m_axi_bresp(m_axi_bresp),
        .m_axi_bvalid(m_axi_bvalid),
        .m_axi_bready(m_axi_bready)
    );

    assign indicator_operational = channel_enable;
    assign indicator_connected = channel_connected;
    assign indicator_error = channel_error[0];

    assign debug_0 = 0;
    assign debug_1 = 0;
endmodule
