lowobservable/channel/(commit log)

2023-11-11 fix pinout
    [pinout.ods]
2024-04-01 wired up
2024-05-21 upgrade KiCad I think
    [breakout1.kicad_sch]
2024-05-21 update net names and XDC map
    [breakout1.kicad_pcb, breakout1.kicad_sch, pinout.ods]
2024-06-19 update pinout workbook
    [pinout.ods]
2024-06-20 compute and wire up parity, parity is not checked
2024-06-20 update bus mapping
    [pinout.ods]
2024-06-21 correct physical bus signal assignment
    [breakout1.xdc]
2024-06-22 enable drivers when frontend is enabled
2024-06-24 fix bug with termination when frontend is not enabled
    [frontend_a.v]
2024-06-24 fix bug with mock CU operational in being held high
    [mock_cu.v]
2024-06-24 update chan_exec prototype to match function return type
2024-06-25 reset mock CU count when selected and add mock NOP command test
    [chan.c, mock_cu.v, test_mock.c]
2024-06-30 add short busy sequence support
    [axi_mock_cu.v, chan.c, chan.h, channel.v, channel_tb.v, mock_cu.c, mock_cu.h, mock_cu.v]
2024-06-30 fix mock CU bus corruption after being selected
    [mock_cu.v]
2024-06-30 set bus out drivers low when idle
2024-07-01 move prep
    [breakout1-B_Cu.gbr, breakout1-B_Mask.gbr, breakout1-B_Paste.gbr, breakout1-B_Silkscreen.gbr, breakout1-Edge_Cuts.gbr, breakout1-F_Cu.gbr, breakout1-F_Mask.gbr, breakout1-F_Paste.gbr]
2024-07-01 add connector pinout
    [pinout.ods]
2025-07-10 implement initial selection short busy sequence
    [channel_out_protocol.v, channel_out_protocol_tb.v]
2025-07-10 add bus in skew delay and fix short busy sequence
    [channel_out_protocol.v]
2025-07-16 no requests are currently supported in selected state
2025-07-17 replace selected with connected and update operational in validation
    [channel_out_protocol.v]
2025-07-18 protocol violation error changes
    [channel_out_protocol.v]
2025-07-26 start - device disabled
2025-07-26 start - device not operational
2025-07-28 clean up libchan error constants
    [chan.c, chan.h, chan_out.c, test_mock.c]
2025-08-02 increase ILA sample depth
2025-08-04 update subchannel and device active after test I/O
2025-08-06 new CXIP protocol, improve Hercules device and cleanup C code
2025-08-08 fix initial status handling
    [axi_mm_channel_out.v, chan.c]
2025-08-15 Replace device address with device number in CXIP protocol
    [chan_out.c]
2025-08-21 Command chaining
